nipisarev/ESP32-C6-Touch-LCD-1.47-CLAUDE/enclosure/README.md

# Корпус: плата сверху, 2×AA снизу

Три детали из PETG, все печатаются без поддержек. Габарит 61.6 × 34.6 × 30.2 мм.

| Файл | Деталь | Как печатать |
|---|---|---|
| `out/tray.stl` | лоток: отсек с полукруглыми ложементами R7.4 под каждую AA, пазы контактов, полка под плату | уже перевёрнут, полкой на стол |
| `out/frame.stl` | рамка: окно экрана, USB-C, язычок BOOT, выключатель, 4 защёлки платы, проушина под шнурок, надпись Tiden.ai | уже перевёрнута, лицом на стол |
| `out/lid.stl` | крышка отсека: «ласточкин хвост» и защёлка | плашмя, метками вверх |
| `out/enclosure.step` | все три детали в сборке | для CAD |

Чертежи и разрезы: `out/1_tray.png`, `out/2_frame.png`, `out/3_lid.png`, `out/4_assembly.png`, вид верха с надписью: `out/5_top.png`.

**Режим печати:** PETG, слой 0.2 мм, 3 периметра, заполнение 20–25 %, без поддержек.
Включить мосты и обдув на мостах: над окном USB и прорезями язычка BOOT печатаются короткие мосты.
Лоток печатается полкой вниз. Ступенька нахлёста даёт свес 1.2 мм по периметру, PETG такой свес держит.

## Сборка
1. **Контакты** (лоток вверх полкой). Пластины опускаются сверху в пазы на торцах и садятся на упор.
   Спереди их держат губки 0.8–0.9 мм:
   - у «+» и «−» с четырёх сторон;
   - у переходной пластины сверху, снизу и посередине. Внешние края открыты: туда заходит «+» батарейки, он стоит не по центру пластины.
   - Торец A (со стороны USB): переходная пластина. Пружина со стороны BOOT, выпуклость с противоположной.
   - Торец B: «+» (с выпуклостью) со стороны BOOT, «−» (с пружиной) с противоположной.
   - Провода к «+» и «−» припаять **до** установки. Они выходят вверх через окна в полке у торца B.
2. **Выключатель** вклеить в карман на стенке рамки со стороны BOOT, рычажок в прорезь. Пометка «I» означает включено.
   Схема: «+» → средний вывод выключателя, крайний со стороны «I» → VBAT; «−» → GND.
   VBAT и GND — верхние отверстия гребёнки у USB, см. `docs/wiring.md`.
3. **Плата защёлкивается в рамку**, винты не нужны. Рамку положить лицом вниз, плату экраном в карман, USB-C к торцу A, и нажать до щелчка.
   Её держат 4 язычка, по 2 на длинных сторонах (в 20 и 36 мм от края с USB): зуб 0.7 мм заходит под край платы.
   Чтобы вынуть плату, отогнуть язычки ногтем к стенке.
   Провода от VBAT и GND (верх гребёнки со стороны RST, 10–12 мм от края с USB) вести к середине платы, не вдоль края: защёлки стоят на 17–23 и 33–39 мм.
4. **Рамку с платой** надеть на лоток и прижать до щелчка: 2 защёлки на каждой длинной стороне.
   Стойки платы ложатся на полку и поджимают плату к рамке, язычки при этом разгружены.
5. **Батарейки** вставляются снизу по меткам на крышке: ячейка со стороны BOOT «+» к торцу B, вторая «+» к торцу A.
   Крышка вдвигается со стороны торца B до щелчка. Чтобы открыть: прижать рифлёный язычок и сдвинуть крышку.

**BOOT** нажимается через язычок на длинной стенке справа, если смотреть на экран, а USB от себя (ямка под палец).
**RST** — отверстие Ø1.6 на противоположной стенке, под скрепку.
**Проушина** для шнурка или брелока — в углу рамки у торца B, со стороны RST. Сквозной прямоугольный канал 2.5 × 6.5 мм (углы R0.8) идёт по диагонали: окно на торце, окно на боку (по 3.5 × 6.5), кромки окон скруглены R0.8, чтобы шнурок не перетирался.
Петлю шнурка продеть в одно окно, вытащить из другого, второй конец пропустить через петлю. Снаружи угла остаётся стойка 2 мм.
Сторону задаёт `BOOT_SIDE`: она взята с чертежа Waveshare, кнопки боковые, у края с USB.

**Надпись Tiden.ai** — на верхней грани под экраном, у торца B (читается, когда USB от себя). Буквы углублены на 0.6 мм, ширина надписи 26 мм, высота 5 мм, шрифт SF Pro Rounded Bold (скруглённые штрихи ~0.9 мм).
Закрасить: залить акриловой краской или краской-маркером, дать подсохнуть и снять излишки с поверхности влажной салфеткой или шлифовкой P600–P800.

## Что измерить перед печатью
Все размеры — параметры в начале `enclosure.py`. После изменения пересобрать (≈15 с):

```sh
/Applications/FreeCAD.app/Contents/Resources/bin/freecadcmd enclosure/enclosure.py
```

| Параметр | Сейчас | Что это |
|---|---|---|
| `SPRING_R` | 4.0 | полуширина окна перед пружиной; основание пружины должно быть ≤ 8 мм |
| `PLATE_SLOT` | 0.9 | паз под пластины; должен быть на 0.4–0.5 мм больше толщины пластины |
| `PLATE_GAP` | 55.0 | расстояние между пазами; пружине остаётся ~4.7 мм в сжатом виде. Пружина в свободном состоянии ≥ 7 мм |
| `CELL_L` | 50.5 | длина AA с «+»; у аккумуляторов с USB бывает до 51 мм |
| `SWITCH_L`, `SWITCH_H` | 9.0, 3.5 | корпус выключателя |
| `LEVER_SLOT_L`, `LEVER_SLOT_H` | 5.0, 2.2 | прорезь под рычажок: ход + ширина рычажка + 0.4 |
| `BTN_FROM_USB`, `BTN_BELOW_PCB` | 7.8, 0.8 | положение кнопок BOOT/RST: от края с USB и ниже спинки платы |
| `HOOK_Y`, `HOOK_LIP` | 20 / 36, 0.7 | защёлки платы: где стоят и насколько заходят под плату. Проверено по чертежу Waveshare (вид сзади): у длинных краёв только ряды отверстий гребёнки, их пятаки начинаются в 1.8 мм от края, зуб заходит на 0.7 |
| `EYE_W`, `EYE_H`, `EYE_BAR` | 2.5, 6.5, 2.0 | канал проушины (поперёк, высота) и стойка снаружи угла |
| `EYE_R_IN`, `EYE_R_MOUTH` | 0.8, 0.8 | скругление углов канала и кромок окон |
| `LOGO_TEXT`, `LOGO_W`, `LOGO_DEPTH`, `LOGO_FONT` | Tiden.ai, 26, 0.6, SF Pro Rounded Bold | надпись на верхней грани: текст, ширина, глубина, шрифт (.ttf/.otf) |

Размеры платы взяты с чертежа Waveshare: рамка 24.55 × 44.5 R5.75, толщина со стойками 10.6. Латунные стойки на плате остаются: ими она опирается на полку.
Если сомневаешься в BOOT и USB, напечатай сначала только рамку (13 мм высотой) и примерь на плату.
