nipisarev/ESP32-C6-Touch-LCD-1.47-CLAUDE/enclosure/out/1_tray.png

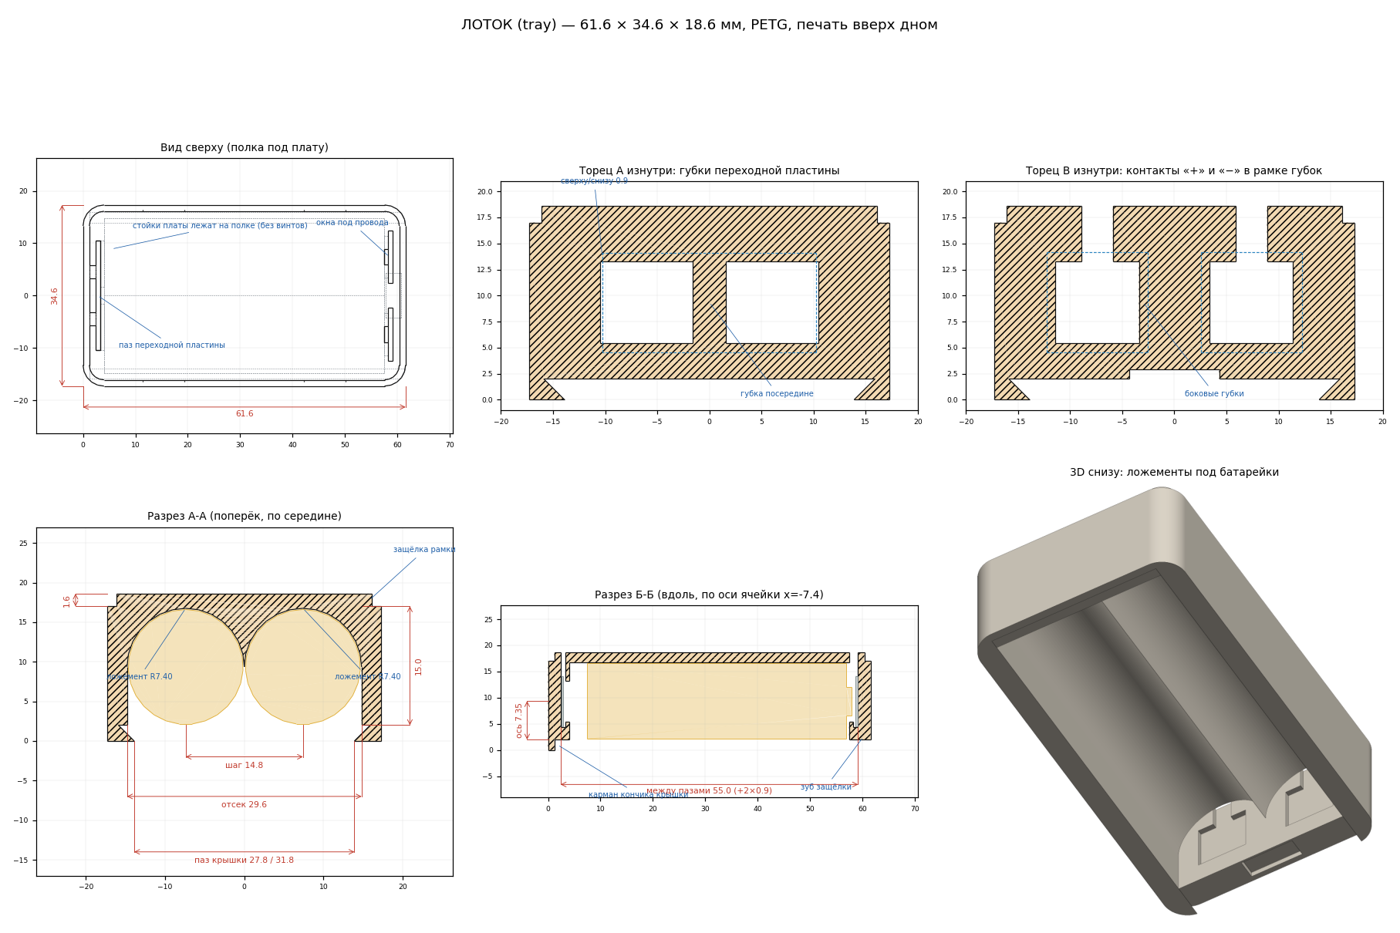
enclosure/out/1_tray.png
