nipisarev/ESP32-C6-Touch-LCD-1.47-CLAUDE/enclosure/out/2_frame.png

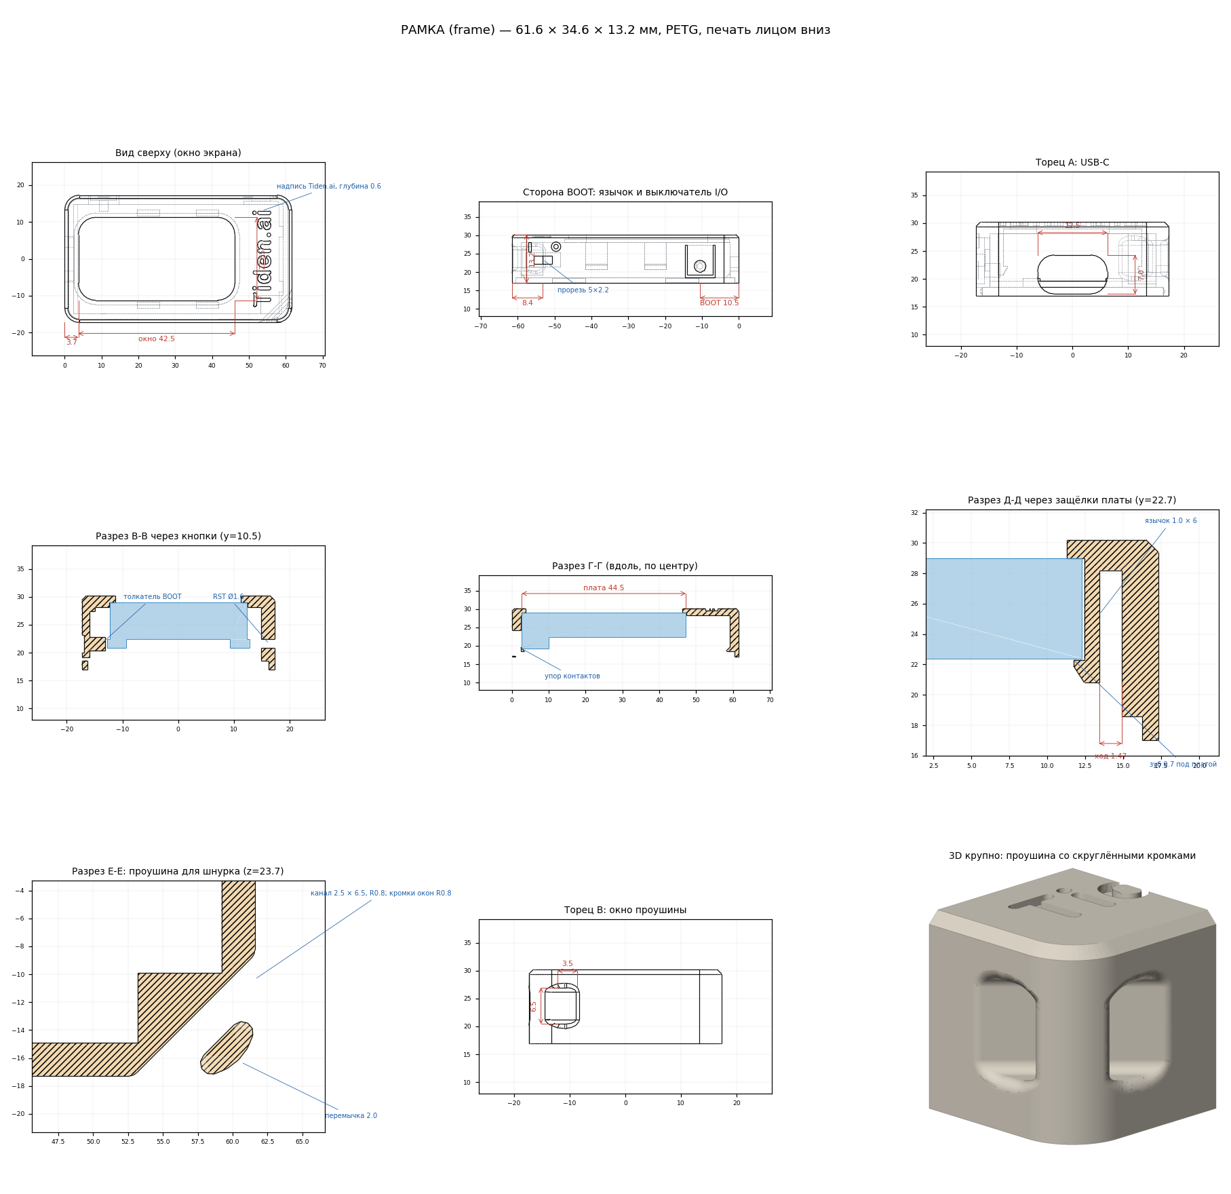
enclosure/out/2_frame.png
