nipisarev/ESP32-C6-Touch-LCD-1.47-CLAUDE/enclosure/out/3_lid.png

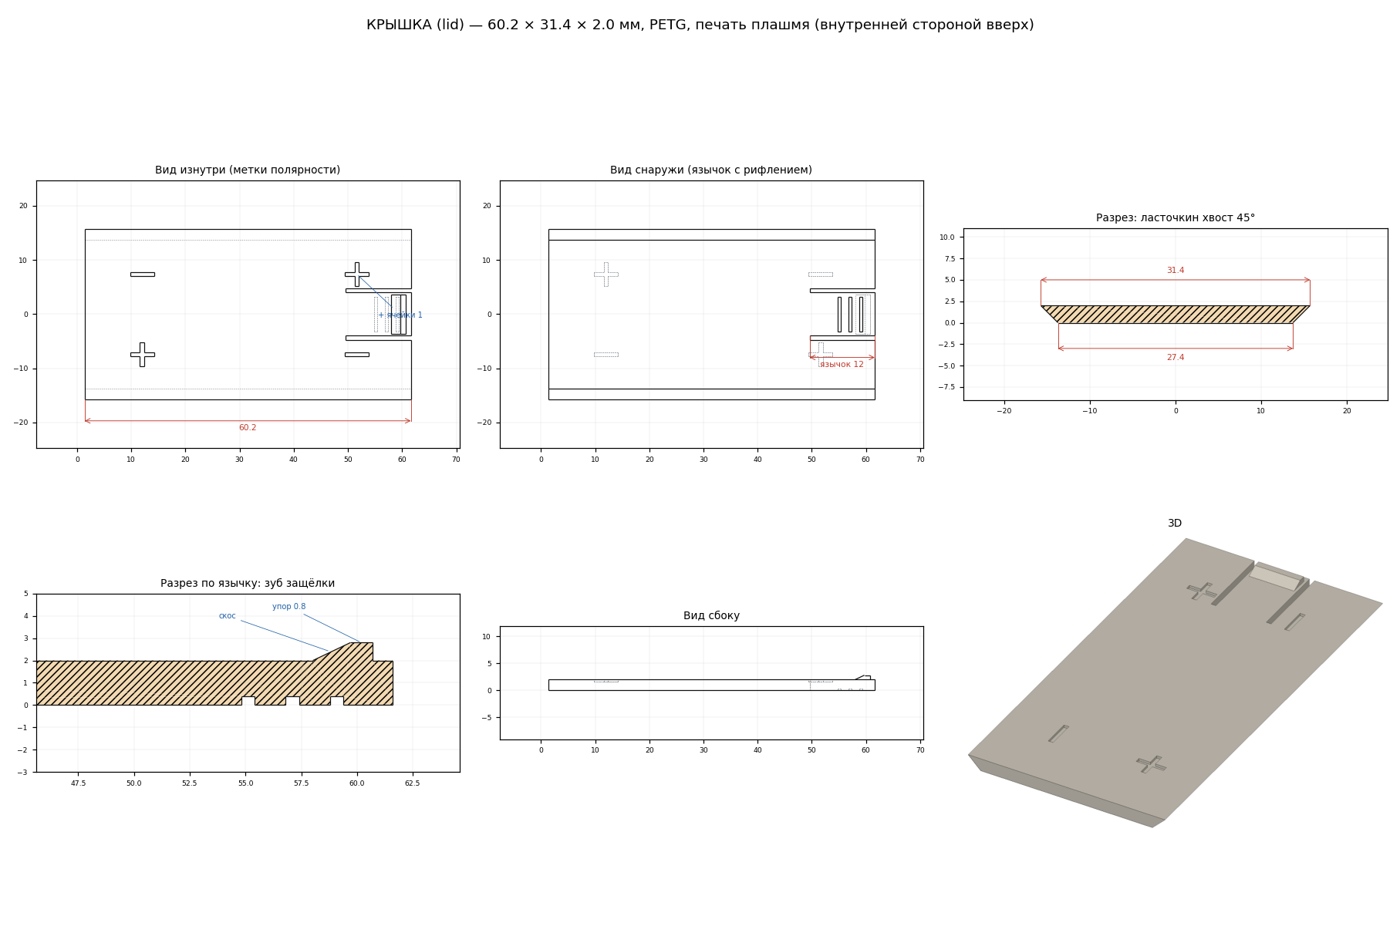
enclosure/out/3_lid.png
