nipisarev/ESP32-C6-Touch-LCD-1.47-CLAUDE/enclosure/out/5_top.png

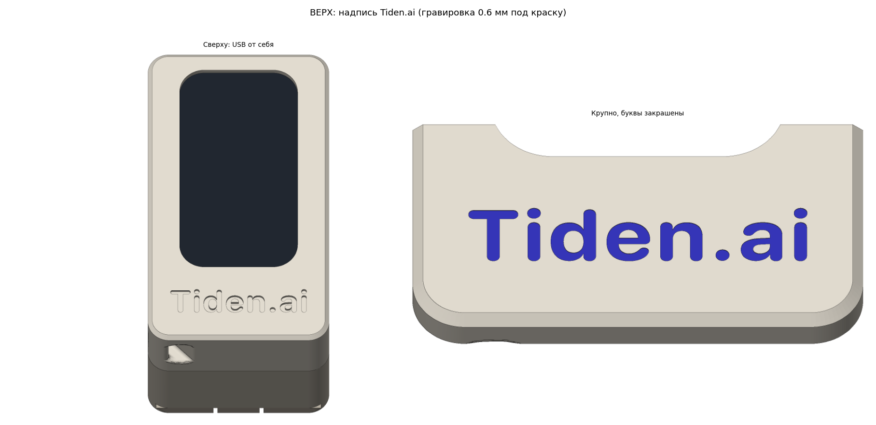
enclosure/out/5_top.png
