nipisarev/ESP32-C6-Touch-LCD-1.47-CLAUDE/enclosure/out/tray.stl

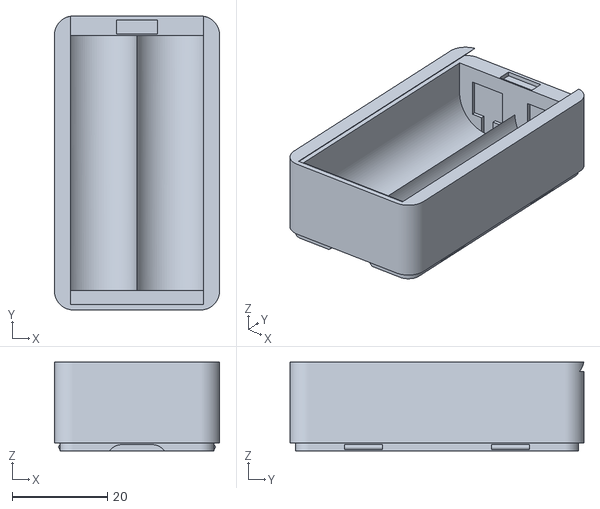
[picture p15: CAD file, 2026-11-08]
enclosure/out/tray.stl
34.6 x 61.6 x 18.6
