nipisarev/ESP32-C6-Touch-LCD-1.47-CLAUDE/enclosure/out/enclosure.step

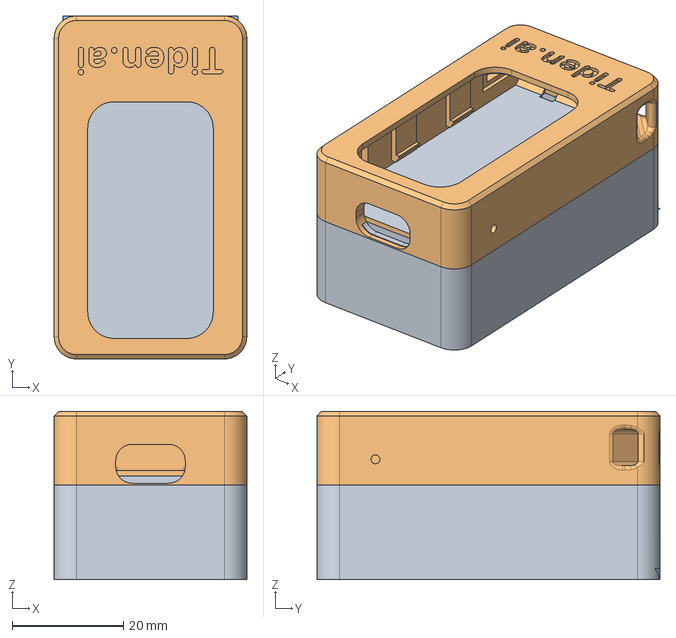
[picture p16: CAD file, 2026-11-08]
enclosure/out/enclosure.step
34.6 x 61.6 x 30.2 mm
