nipisarev/ESP32-C6-Touch-LCD-1.47-CLAUDE/enclosure/out/lid.stl

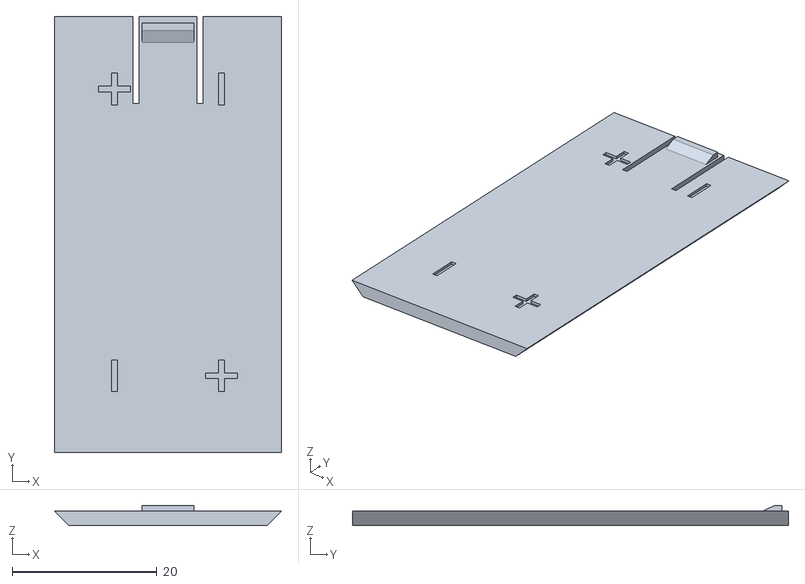
[picture p17: CAD file, 2026-11-08]
enclosure/out/lid.stl
31.4 x 60.2 x 2.80
