nipisarev/ESP32-C6-Touch-LCD-1.47-CLAUDE/enclosure/out/frame.stl

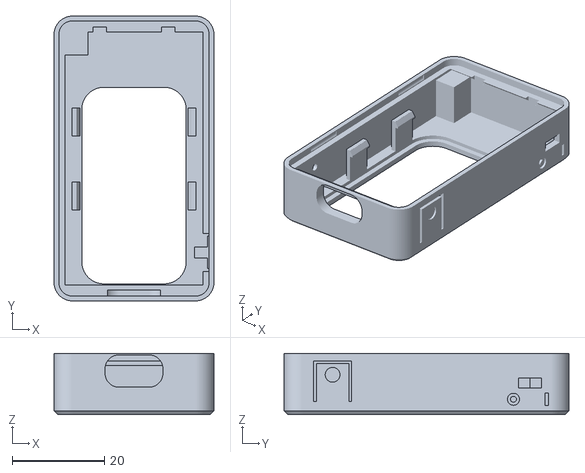
[picture p18: CAD file, 2026-11-08]
enclosure/out/frame.stl
34.6 x 61.6 x 13.2
