nipisarev/ESP32-C6-Touch-LCD-1.47-CLAUDE/docs/wiring.md

# Подключение питания

## Основной вариант: 2 × USB-аккумулятора AA 1.5 V последовательно

```
 [+ AA][- ]─[+ AA][- ]          держатель 2×AA (последовательно, ~3.0 V)
   │                 │
   │                 └──────────────── отверстие GND (верхний ряд, рядом с VBAT)
   └──── тумблер ───────────────────── отверстие VBAT (верхний ряд, крайнее)
```

- Батареи заряжаются отдельно, через micro-USB на корпусе каждой.
- **USB-C к плате подключать только при выключенном тумблере.** Это касается и прошивки, и `monitor`.
  Встроенный зарядник ETA6098 при USB начнёт заряжать всё, что висит на VBAT, током до 2 A до 4.2 V.
  Аккумуляторы AA со встроенным понижающим преобразователем на 1.5 V такой обратный ток не выдерживают.
- Напряжение: сборка даёт ~3.0 V, после LDO на шине 3V3 остаётся ~2.8–2.9 V.
  Это ниже минимума ESP32-C6 по даташиту (3.0 V), но обычно работает.
  Признаки нехватки: перезагрузки (brownout в логе), тусклый экран, мусор на экране.
- Индикатора заряда нет: выход таких батарей стабилизирован, а на исходе они отключаются резко.

## Запасной вариант: LiPo EEMB LP552036 360 mAh

Встроенный зарядник с R18 = 82 кОм заряжает током 2 A. Для 360 mAh это ~5.5C, так нельзя.

| вместо R18 | ток заряда | для 360 mAh |
|---|---|---|
| 82k (заводской) | 2.0 A | опасно |
| 270k | 0.61 A | слишком много |
| 270k + 270k последовательно | 0.30 A | годится |

Формула из даташита ETA6098: ICHG ≈ 0.205 A/мкА × 0.8 В / RISET. Она сходится с точками 82k→2 A и 150k→1.2 A.

**R18:** резистор 0402 прямо над чипом ETA6098 (чёрный квадрат 3×3 мм, справа от него светлый дроссель L3).
Он стоит под 4-м отверстием верхнего ряда, если считать от VBAT. Одна площадка звонится на GND, вторая (ISET) уходит к чипу.

Порядок замены:
1. Измерить новые резисторы мультиметром. Маркировка «R270» означает 0.27 Ом, а не 270 кОм. Такой ставить нельзя.
2. Батарея и USB отключены. Снять R18.
3. Цепочку 270k + 270k уложить на каптон и соединить тонким проводом с площадкой ISET. Провод держать короче 1–2 см.
   Второй конец цепочки соединить с площадкой GND бывшего R18 или с отверстием GND.
4. Проверить: между площадками ~540 кОм, ISET не звонится на GND.
5. Первый заряд под присмотром, батарея не должна греться.

Пока R18 снят и ничего не впаяно, не подключать USB при подключённой батарее.

Батарея HHD503040 300 mAh одна не годится по той же причине. Параллельно с EEMB её можно ставить только после замены R18, при одинаковом напряжении ячеек и с платой защиты на каждой.
