nipisarev/ESP32-C6-Touch-LCD-1.47-CLAUDE/enclosure/out/4_assembly.png

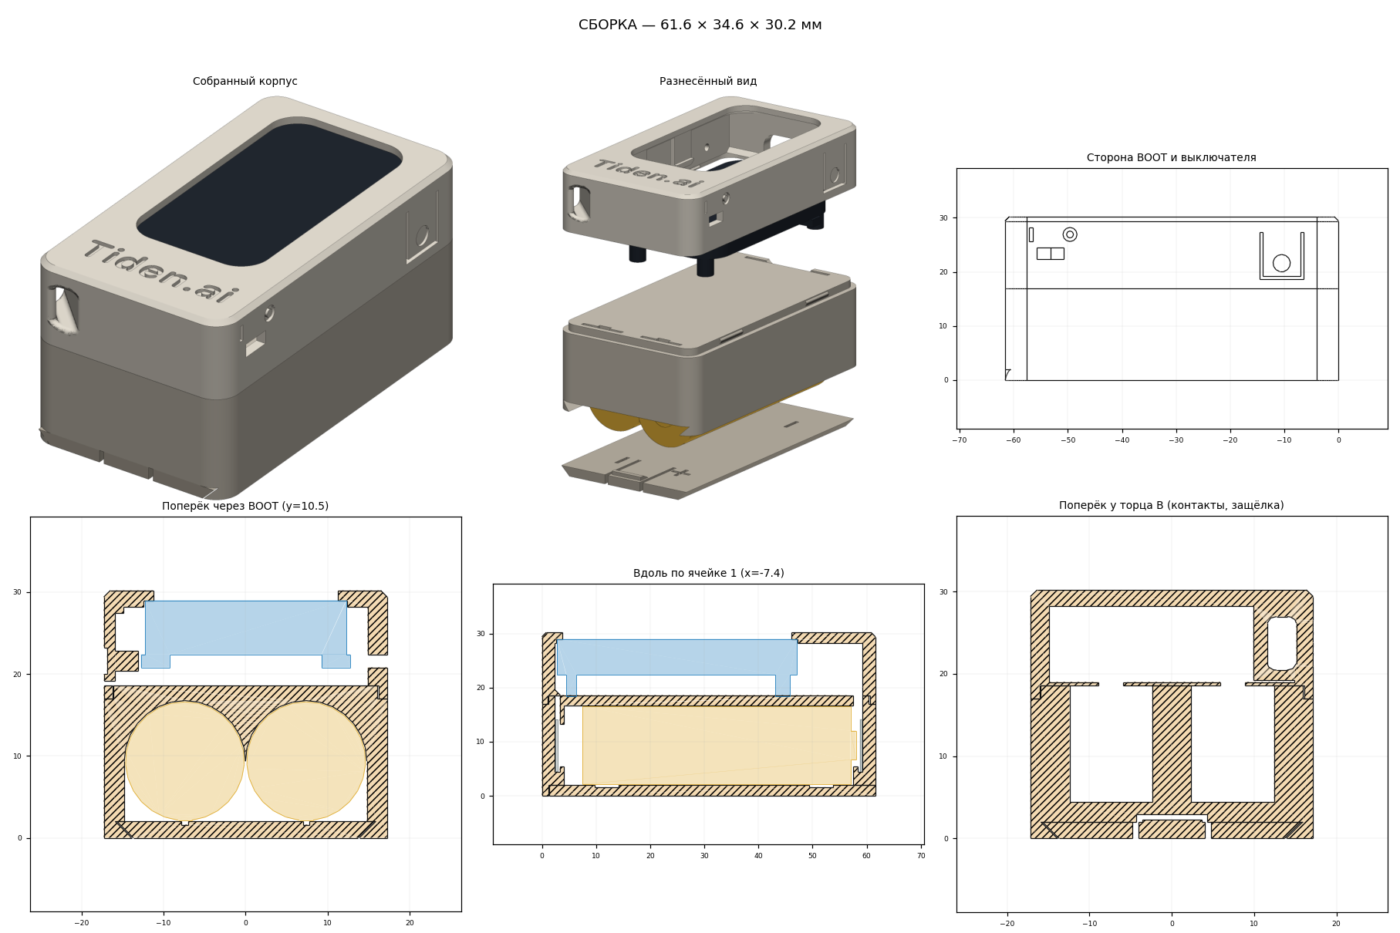
enclosure/out/4_assembly.png
