nipisarev/ESP32-C6-Touch-LCD-1.47-CLAUDE/tasks/todo.md

# Claude mascot — todo

План: ~/.claude/plans/tender-conjuring-tarjan.md

- [x] 0. Дымовой тест: на плате 30 fps, 13–14 мс/кадр, heap 336 KB; ориентация, цвета, тач подтверждены пользователем
- [x] 0b. docs/wiring.md (фото с R18 не делал: пользователь уже нашёл R18, PIL/ImageMagick нет)
- [x] 1. Каркас: вендорные компоненты, platform_esp, engine/gfx
- [x] 2. tools/extract_mascot.mjs: статический парсер бандла + ручной порт таймлайнов (кадры 36/12/8/8 сверены)
- [x] 3. mascot_anim (один плеер для всех 4), host-превью PNG; масштаб 1.0, перекраска тёмного на чёрном фоне
- [x] 4. Сцены: show-режиссёр (переходы, сон с кроватью), menu 6 плиток, runner, catch, pet, tower, pong (+ host-сценарии)
- [x] 5. Сборка без предупреждений: образ ~527 KB (83% раздела свободно), heap ~284 KB, 30 fps, кадр 13–19 мс
- [x] 6. Прошито, пользователь проверил: анимации, меню, runner, catch, pet, tower; правки по pong и сну
- [x] 7. README

## Решения по ходу
- Фон чёрный (пользователь), цвет: gamma 1.4 / saturation ×1.1 (выбран на устройстве).
- Питание: 2×AA 1.5 V USB-Li-ion → тумблер → VBAT; USB только при OFF (docs/wiring.md).
- Долгий тап блокируется во время раунда CATCH/PONG (иначе меню открывалось при удержании пальца).
- PONG: поле с рамкой и отступами (x 30…314, y 24…168), ракетка объёмная, относительное управление ×1.5.

## Ревью (2026-11-07)
- Все сцены проверены пользователем на устройстве: SHOW (4 номера + переходы, сон с кроватью), RUN, CATCH, PET, TOWER, PONG.
- Плата: 30 fps стабильно, кадр 13–19 мс, heap ~284 KB без утечек за 4 мин, без паник.
- Осталось у пользователя: распаять питание 2×AA → тумблер → VBAT/GND (docs/wiring.md), проверить работу от батарей (риск brownout при ~2.9 V на 3V3).

## Итерация 2 (2026-11-07)
- [x] Сцены с реквизитом: блокнот, телефон 90-х, кофе, хот-дог + смузи — проверено пользователем
- [x] Дом: комната (пол, дверь, окно с луной/солнцем, картина, тумба с цветком), день/ночь
- [x] Прогулка через дверь в дневной/ночной парк с собаками, ~раз в минуту
- [x] Полив цветка (вянет за ~5 мин), маскот вытягивается и льёт сверху — проверено
- [x] Встряхивание (QMI8658A): «землетрясение» по всей комнате, головокружение со спиралями и искрами Claude, будит из сна; SHOW + PET — проверено пользователем
- [x] Прогулка «по кругу»: только слева направо, домик возвращается справа — проверено
- [x] POOL: вода по реальной гравитации (оси откалиброваны позами), плескание, плавучесть, уточка, звёзды, маска с трубкой — проверено
- [x] Меню: 2 страницы по 4 плитки, свайп/перетаскивание, точки — проверено
- [x] RACE: псевдо-3D от первого лица, руль с лапками по наклону, 3 уровня, 3 полосы, соперники и места, олень/аварии (2-3), трещины/дым, финиш в 3/4 с конфетти — проверено
- [x] Кнопка BOOT (GPIO9 по схеме) открывает/закрывает меню из любого режима — проверено

## Итерация 3: RACE — случайные гонки (2026-11-07)
- [x] Случайность каждой гонки: убрать фиксированные rng_seed, подмешать время тапа
- [x] Генератор трассы А→Б: прямые, дуги, повороты, S-связки, шпильки; ограничение курса
- [x] Карта трассы во весь экран на отсчёте 3-2-1 (прорисовка, точки на старте, флажок)
- [x] Препятствия: стог сена (EASY), дорожные работы (MEDIUM), камнепад (HARD)
- [x] Соперники с характерами: темп, повороты, виляние, обгоны, ошибки, случайная сетка
- [x] Обочина: вне трассы ×0.15 скорости, деревья сбиваются (минус жизнь)
- [x] Раскадровки (racemaps, racehay, raceworks, racerocks, raceoffroad), сборки без предупреждений, прошивка

### Ревью итерации 3
- Причина повторяющихся гонок: фиксированные rng_seed в build_level. Убраны, в start_level подмешивается время тапа.
- Сборки на Mac и ESP-IDF без предупреждений, прошито. На устройстве пользователь ещё не проверял.
- Раскадровки:
  - racemaps: две разные карты EASY подряд, MEDIUM, HARD;
  - race: стог сена;
  - race2: отбойники;
  - racerocks: камнепад;
  - race3: занос соперника;
  - raceoffroad: скорость 9 вместо 60, удар о дерево −1 жизнь;
  - racecrash, racefin: без изменений.
- Трейс соперников: в двух гонках с разным зерном разные позиции, полосы и ошибки. Трейс удалён.

## Итерация 4: PET — комната, жесты, расчёска, кофе (2026-11-07)
- [x] Комната из SHOW, три кнопки слева (♥ / расчёска / кофе), активная подсвечена
- [x] Жесты: тап по голове/руке/ногам/телу, щекотка (3 тапа), поглаживание
- [x] Взять пальцем (0.4 с), таскать, бросок с отскоками, головокружение после сильного броска; блокировка долгого нажатия
- [x] Вихры (вход, бросок, встряска, время) и расчёска: искорки, радость и +1 за чистого Claude
- [x] Кофе от первого лица (pet_coffee.c): пакетик, молоко, кипяток, налив, питьё, возврат с паром и +3
- [x] Раскадровки (petgest, petstroke, petgrab, petcomb, petcoffee, pet, petshake), сборки без предупреждений, прошивка
- [x] README

### Ревью итерации 4
- Сборки на Mac и ESP-IDF без предупреждений, прошито. На устройстве пользователь ещё не проверял.
- Старые PET-сессии на Mac открывали CATCH: меню давно стало 2×2, плитка PET теперь в (240, 120). Исправлено.
- Поглаживание сначала не давало сердечек: путь обнулялся на каждом касании (80 px < 120). Теперь путь копится между проводками, сердечко каждые 100 px.
- Предметы кофе: клетка спрайта увеличена с 3 до 5 px, при 3 они были 2–3 мм на экране. Рука держит предмет снизу и не закрывает его.
- Раскадровки:
  - petgest: голова, рука, ноги, тело, щекотка с «HA»;
  - petstroke: прищур, «мурчание», 2 сердечка;
  - petgrab: подъём, бросок, отскок, головокружение, вихры, возврат;
  - petcomb: вихры убираются с искорками, радость и +1;
  - petcoffee: три налива, питьё с «GULP», комната с паром и +3;
  - pet, petshake: без регрессий.

## Итерация 5: часы Tiden над дверью (2026-11-08)
- [x] Циферблат из логотипа Tiden (SVG → маска 28×28, `tools/logo_clock.py`): диск синий, волна зелёная, деревянный обод 3 px в цветах двери, латунные метки 12-3-6-9
- [x] Стрелки часовая/минутная/секундная, метки 12-3-6-9; время = 10:10 + время с включения (часов реального времени на плате нет)
- [x] Кнопки PET опущены под часы; раскадровки show, walk, pet*; сборки без предупреждений, прошито

## Итерация 6: полив по тапу (2026-11-08)
- [x] SHOW: тап по вянущему цветку (жажда ≥ 0.25) → Claude идёт поливать; из покоя/взгляда/ходьбы сразу, из остальных номеров (сон, реквизит, шоу) после них; встряска во время пути к цветку не теряет запрос
- [x] Раскадровки flower (тап → полив, цветок выпрямился), wiltsleep (тап во сне → просыпается → поливает); сборки без предупреждений, прошито

## Итерация 7: меньше флага, равномернее (2026-11-08)
- [x] Шоу-номера реже (раз в 50–80 с вместо 18–32) и поровну: прыжки, зал, конфетти по 1, флаг 0.2
- [x] Реквизит: кофе, еда, блокнот 1.1 → 2.0, телефон 1.1 → 1.5; последний номер с реквизитом не повторяется даже через «посмотреть/пройтись»
- [x] За час SHOW на Mac (сессия showlong): еда 28, прогулка 27, блокнот 24, кофе 24, телефон 18, зал 17, полив 16, прыжки 14, конфетти 13, флаг 4 (было: флаг 24, зал 28, еда 8 за час); повторов подряд 0; сборки без предупреждений, прошито

## Итерация 8: встряска на прогулке (2026-11-08)
- [x] Один раз за прогулку, пока он в парке: днём мяч, ночью гроза; во время мяча прогулка стоит на паузе и потом продолжается домой
- [x] ball.c: объёмный полупрозрачный мяч 34 px с логотипом Tiden с двух сторон (дальняя сторона видна сквозь ближнюю, блик, кромка), вращение по двум осям, целочисленный расчёт (у C6 нет FPU)
- [x] Мяч: падает с неба, два отскока, подкат, пинок на голову, 4 удара головой с подскоком, вылет вверх-вправо, радость
- [x] Гроза: тёмное небо и тучи, двойные вспышки с молнией, косой ливень и брызги; прыжок испуга, бег домой ×3 с руками над головой
- [x] Дома: ливень в окне стихает, капли стекают по телу и капают, лужа; три волны дрожи от ног вверх (двигаются только пиксели маскота), брызги в стороны; ^^ и норма
- [x] Раскадровки parkball (SHOW_FORCE=park SHOW_DAY=1), parkstorm (SHOW_FORCE=park); сборки без предупреждений, прошито

## Итерация 9: дрожь одной волной; сезоны и погода в RACE (2026-11-08)
- [x] Дрожь после грозы: одна медленная волна 1.8 с от ног к макушке, S-рябь и вставшая шерсть по бокам на фронте волны
- [x] RACE: уровень задаёт только трассу, скорость и препятствия; всегда день; случайный сезон (не два раза подряд) и погода под сезон
- [x] Лето: озёра у дороги (песок, вода до края экрана, блики), круглые холмы; ясно или дождь (серое небо, мокрая тёмная дорога, косые струи)
- [x] Осень: серпантин (больше S-связок, короче прямые), лес из жёлтых/оранжевых/красных/зелёных крон на горизонте и вдоль дороги, листопад; туман (затухание по глубине) или дождь
- [x] Зима: горы со снежными шапками, заснеженные ели, снежная земля, лужи → лёд; снегопад
- [x] Карта на отсчёте: «УРОВЕНЬ  СЕЗОН ПОГОДА», число поворотов, фон под сезон
- [x] Производительность на плате (осень): кадр 46 → 27.5 мс. gfx_color стал целочисленным (был ~12 мкс float на вызов без FPU), купола крон по таблице, курсор изгиба, объекты по глубине за один проход; зима со снегом 30–32 мс, лето с дождём 28–31 мс
- [x] Раскадровка raceseason (RACE_SEASON, RACE_WEATHER, RACE_AUTOPILOT), сборки без предупреждений, прошито
