nipisarev/ESP32-C6-Touch-LCD-1.47-CLAUDE/(notices)

Notices in the files:
README.md:
License: MIT
